SkenHub/-2022-/MDD/回路/部品発注_中尾拓真.xlsx

NAME | 個数 | 単価 | 小計 | 型番 | 注文コード | 手配先 | 販売元 | URL | 備考
20pF ±5% 50V セラミックコンデンサ C0G、NP0 0603（1608メートル法） | 20 | 5.3 | 106 | CC0603JRNPO9BN200 |  | digikey |  | https://www.digikey.jp/product-detail/ja/yageo/CC0603JRNPO9BN200/311-1424-1-ND/2833730
4.7µF ±10% 16V セラミックコンデンサ X5R 0805（2012メートル法） | 10 | 5.3 | 53 | CL21A475KOFNNNG |  | digikey |  | https://www.digikey.jp/product-detail/ja/samsung-electro-mechanics/CL21A475KOFNNNG/1276-6463-1-ND/5958091
0.1µF ±10% 50V セラミックコンデンサ X7R 0603（1608メートル法） | 100 | 6.85 | 685 | CL10B104KB8NNNC |  | digikey |  | https://www.digikey.jp/product-detail/ja/samsung-electro-mechanics/CL10B104KB8NNNC/1276-1000-1-ND/3889086
2.2µF ±20% 50V セラミックコンデンサ X5R 0805（2012メートル法） | 10 | 22.6 | 226 | UMK212ABJ225MG-T |  | digikey |  | https://www.digikey.jp/product-detail/ja/taiyo-yuden/UMK212ABJ225MG-T/587-4962-1-ND/6563805
4.7µF ±10% 50V セラミックコンデンサ X5R 0805（2012メートル法） | 10 | 29.7 | 297 | GRM21BR61H475KE51L |  | digikey |  | https://www.digikey.jp/product-detail/ja/murata-electronics/GRM21BR61H475KE51L/490-10751-1-ND/5251349
3 ポジション ヘッダ コネクタ 0.098インチ（2.50mm） 面実装、ライトアングル 錫 | 25 | 82.2 | 2055 | S3B-XH-SM4-TB(LF)(SN) | 455-2263-1-ND | digikey | JST Sales America Inc. | https://www.digikey.jp/product-detail/ja/jst-sales-america-inc/S3B-XH-SM4-TB-LF-SN/455-2263-1-ND/1651061
4 ポジション ヘッダ コネクタ 0.098インチ（2.50mm） 面実装、ライトアングル 錫 | 40 | 79.1 | 3164 | S4B-XH-SM4-TB(LF)(SN) | 455-2262-1-ND | digikey | JST Sales America Inc. | https://www.digikey.jp/product-detail/ja/jst-sales-america-inc/S4B-XH-SM4-TB-LF-SN/455-2262-1-ND/1651060
ダイオード ショットキー 10V 3A（DC） 面実装 SOD-323 | 6 | 44 | 264 | BAT60JFILM | 497-3707-1-ND | digikey | STMicroelectronics | https://www.digikey.jp/product-detail/ja/stmicroelectronics/BAT60JFILM/497-3707-1-ND/686425
表面実装 青色ＬＥＤ ［３２１６］ ＯＳＢ５１２０６４１Ｅ （１０個入） | 2 | 120 | 240 | OSB5120641E | I-09635 | 秋月電子 | OptoSupply | http://akizukidenshi.com/catalog/g/gI-09635/
8MHz ±20ppm 水晶 18pF 200 Ohms 4-SMD、リードなし | 6 | 126 | 756 | ABM3B-8.000MHZ-B2-T | 535-9720-1-ND | digikey | Abracon LLC | https://www.digikey.jp/product-detail/ja/abracon-llc/ABM3B-8.000MHZ-B2-T/535-9720-1-ND/1873254
10 kOhms ±1% 0.01W チップ抵抗 0603（1608メートル法） アンチサルファー 厚膜 | 10 | 6.6 | 66 | CR0603-FX-1002EAS |  | digikey | Bourns Inc. | https://www.digikey.jp/product-detail/ja/bourns-inc/CR0603-FX-1002EAS/CR0603-FX-1002EASCT-ND/6830120
4.7 kOhms ±5% 0.1W、1/10W チップ抵抗 0603（1608メートル法） 耐湿性 厚膜 | 10 | 1.7 | 17 | CR0603-JW-472ELF | CR0603-JW-472ELFCT-ND | digikey | Bourns Inc. | https://www.digikey.jp/product-detail/ja/bourns-inc/CR0603-JW-472ELF/CR0603-JW-472ELFCT-ND/3592926
1 kOhms ±5% 0.1W、1/10W チップ抵抗 0603（1608メートル法） 耐湿性 厚膜 | 10 | 1.7 | 17 | CR0603-JW-102ELF |  | digikey | Bourns Inc. | https://www.digikey.jp/product-detail/ja/bourns-inc/CR0603-JW-102ELF/CR0603-JW-102ELFCT-ND/3740984
120 Ohms ±5% 0.1W、1/10W チップ抵抗 0603（1608メートル法） 耐湿性 厚膜 | 20 | 1.9 | 38 | CR0603-JW-121ELF |  | digikey | Bourns Inc. | https://www.digikey.jp/product-detail/ja/bourns-inc/CR0603-JW-121ELF/CR0603-JW-121ELFCT-ND/3925335
表面実装用タクトスイッチ（５個入） | 2 | 100 | 200 | SKRPACE010 | P-06185 | 秋月電子 | アルプス電気株式会社(ALPS) | http://akizukidenshi.com/catalog/g/gP-06185/
表面実装ＤＩＰスイッチ ４Ｐ | 6 | 100 | 600 | KHS42E | P-08929 | 秋月電子 | オータックス株式会社(OTAX) | http://akizukidenshi.com/catalog/g/gP-08929/
IC TRANSCEIVER FULL 1/1 8SO | 6 | 169 | 1014 | MAX3058ASA+T | MAX3058ASA+CT-ND | digikey | Maxim Integrated | https://www.digikey.jp/product-detail/ja/maxim-integrated/MAX3058ASA-T/MAX3058ASA-CT-ND/5402248
IC REG LINEAR 3.3V 500MA SOT23-5 | 6 | 58 | 348 | SPX3819M5-L-3-3/TR | 1016-1873-1-ND | digikey | MaxLinear, Inc. | https://www.digikey.jp/product-detail/ja/maxlinear-inc/SPX3819M5-L-3-3-TR/1016-1873-1-ND/3586590
STM32F446RET6 | 2 | 772.2 | 1544.4 | STM32F446RET6 | 497-15376-ND | digikey | STMicroelectronics | https://www.digikey.jp/product-detail/ja/stmicroelectronics/STM32F446RET6/497-15376-ND/5175962
