SkenHub/-2022-/ver1.brd

## EAGLE design ver1.brd (2023-12-15)

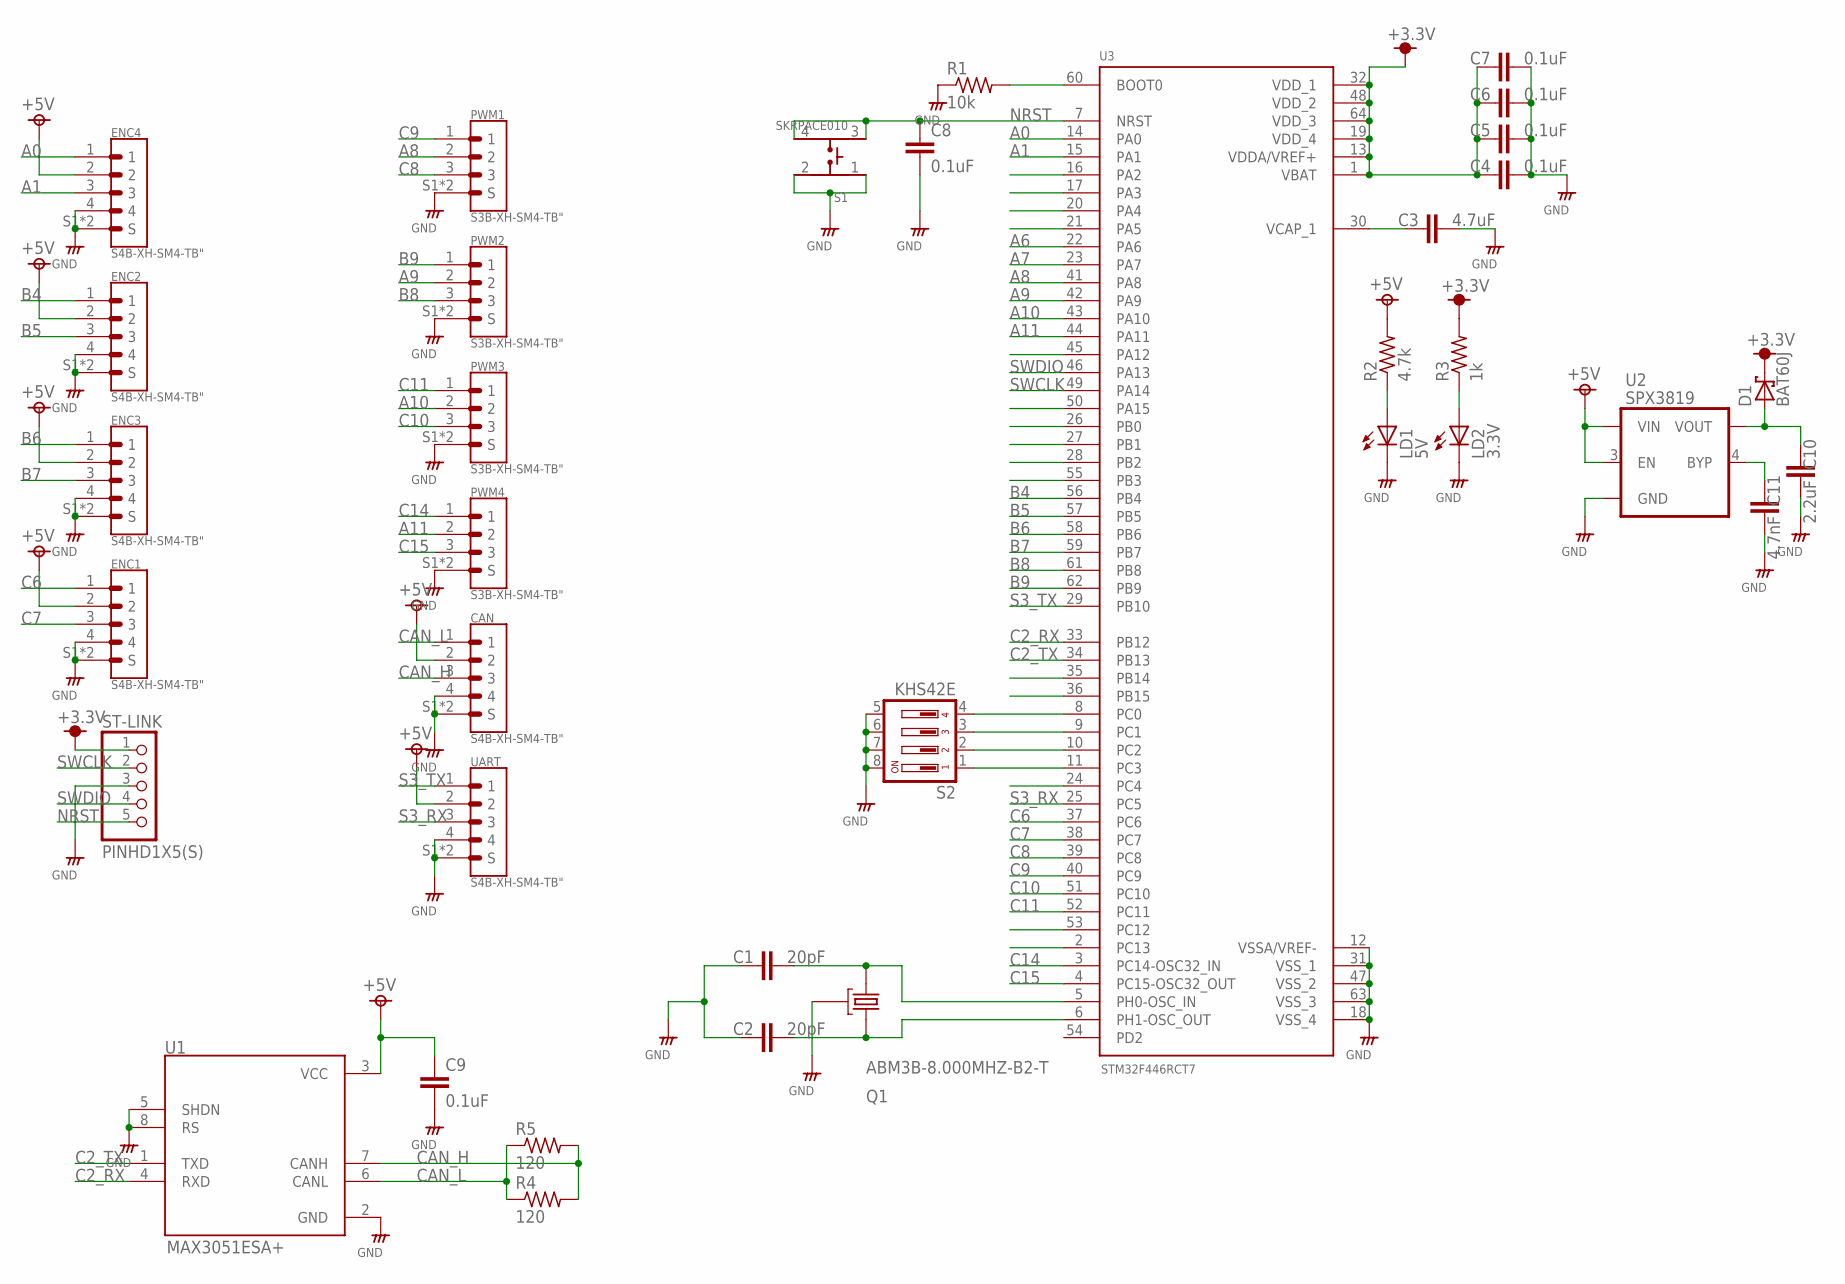
[picture p10: schematic ver1.sch]

Parts:
C1, C2: 20pF; C0603
C3: 4.7uF; C0805
C4, C5, C6, C7: 0.1uF; C0805
C8, C9: 0.1uF; C0603
C10: 2.2uF; C0603
C11: 4.7nF; C0603
CAN: S4B-XH-SM4-TB"; S4B-XH-SM4-TB
D1: BAT60J; SOD323_ST
ENC1, ENC2, ENC3, ENC4: S4B-XH-SM4-TB"; S4B-XH-SM4-TB
LD1: 5V; CHIP-LED3216
LD2: 3.3V; CHIP-LED3216
PWM1, PWM2, PWM3, PWM4: S3B-XH-SM4-TB"; S3B-XH-SM4-TB
Q1: ABM3B-8.000MHZ-B2-T; OSCCC500X320X110-4N
R1: 10k; R0603
R2: 4.7k; R0603
R3: 1k; R0603
R4, R5: 120; R0603
S1: SKRPACE010; SW_SKRPACE010
S2: KHS42E
ST-LINK: PINHD1X5(S); 1X5(XH_S)
U1: MAX3051ESA+; SOIC127P600X175-8N
U2: SPX3819; SOT23-5
U3: STM32F446RCT7; QFP50P1200X1200X160-64N
UART: S4B-XH-SM4-TB"; S4B-XH-SM4-TB

Connections:
+3V3: C4.1, C5.1, C6.1, C7.1, D1.C, R3.2, ST-LINK.1, U3.1 (VBAT), U3.13 (VDDA/VREF+), U3.19 (VDD_4), U3.32 (VDD_1), U3.48 (VDD_2), U3.64 (VDD_3)
+5V: C9.1, CAN.2, ENC1.2, ENC2.2, ENC3.2, ENC4.2, R2.2, U1.3 (VCC), U2.1 (VIN), U2.3 (EN), UART.2
A0: ENC4.1, U3.14 (PA0)
A1: ENC4.3, U3.15 (PA1)
A6: U3.22 (PA6)
A7: U3.23 (PA7)
A8: PWM1.2, U3.41 (PA8)
A9: PWM2.2, U3.42 (PA9)
A10: PWM3.2, U3.43 (PA10)
A11: PWM4.2, U3.44 (PA11)
B4: ENC2.1, U3.56 (PB4)
B5: ENC2.3, U3.57 (PB5)
B6: ENC3.1, U3.58 (PB6)
B7: ENC3.3, U3.59 (PB7)
B8: PWM2.3, U3.61 (PB8)
B9: PWM2.1, U3.62 (PB9)
C2_RX: U1.4 (RXD), U3.33 (PB12)
C2_TX: U1.1 (TXD), U3.34 (PB13)
C6: ENC1.1, U3.37 (PC6)
C7: ENC1.3, U3.38 (PC7)
C8: PWM1.3, U3.39 (PC8)
C9: PWM1.1, U3.40 (PC9)
C10: PWM3.3, U3.51 (PC10)
C11: PWM3.1, U3.52 (PC11)
C14: PWM4.1, U3.3 (PC14-OSC32_IN)
C15: PWM4.3, U3.4 (PC15-OSC32_OUT)
CAN_H: CAN.3, R4.2, R5.2, U1.7 (CANH)
CAN_L: CAN.1, R4.1, R5.1, U1.6 (CANL)
GND: C1.1, C2.1, C3.2, C4.2, C5.2, C6.2, C7.2, C8.2, C9.2, C10.2, C11.2, CAN.4, CAN.S1 (S), CAN.S2 (S), ENC1.4, ENC1.S1 (S), ENC1.S2 (S), ENC2.4, ENC2.S1 (S), ENC2.S2 (S), ENC3.4, ENC3.S1 (S), ENC3.S2 (S), ENC4.4, ENC4.S1 (S), ENC4.S2 (S), LD1.C, LD2.C, PWM1.S1 (S), PWM1.S2 (S), PWM2.S1 (S), PWM2.S2 (S), PWM3.S1 (S), PWM3.S2 (S), PWM4.S1 (S), PWM4.S2 (S), Q1.2 (GND), Q1.4 (GND), R1.1, S1.1, S1.2, S2.5, S2.6, S2.7, S2.8, ST-LINK.3, U1.2 (GND), U1.5 (SHDN), U1.8 (RS), U2.2 (GND), U3.12 (VSSA/VREF-), U3.18 (VSS_4), U3.31 (VSS_1), U3.47 (VSS_2), U3.63 (VSS_3), UART.4, UART.S1 (S), UART.S2 (S)
unnamed: C1.2, Q1.1, U3.5 (PH0-OSC_IN)
unnamed: C2.2, Q1.3, U3.6 (PH1-OSC_OUT)
unnamed: R1.2, U3.60 (BOOT0)
unnamed: C3.1, U3.30 (VCAP_1)
unnamed: LD1.A, R2.1
unnamed: LD2.A, R3.1
unnamed: C11.1, U2.4 (BYP)
unnamed: C10.1, D1.A, U2.5 (VOUT)
unnamed: S2.4, U3.8 (PC0)
unnamed: S2.3, U3.9 (PC1)
unnamed: S2.2, U3.10 (PC2)
unnamed: S2.1, U3.11 (PC3)
NRST: C8.1, S1.3, S1.4, ST-LINK.5, U3.7 (NRST)
S3_RX: U3.25 (PC5), UART.3
S3_TX: U3.29 (PB10), UART.1
SWCLK: ST-LINK.2, U3.49 (PA14)
SWDIO: ST-LINK.4, U3.46 (PA13)

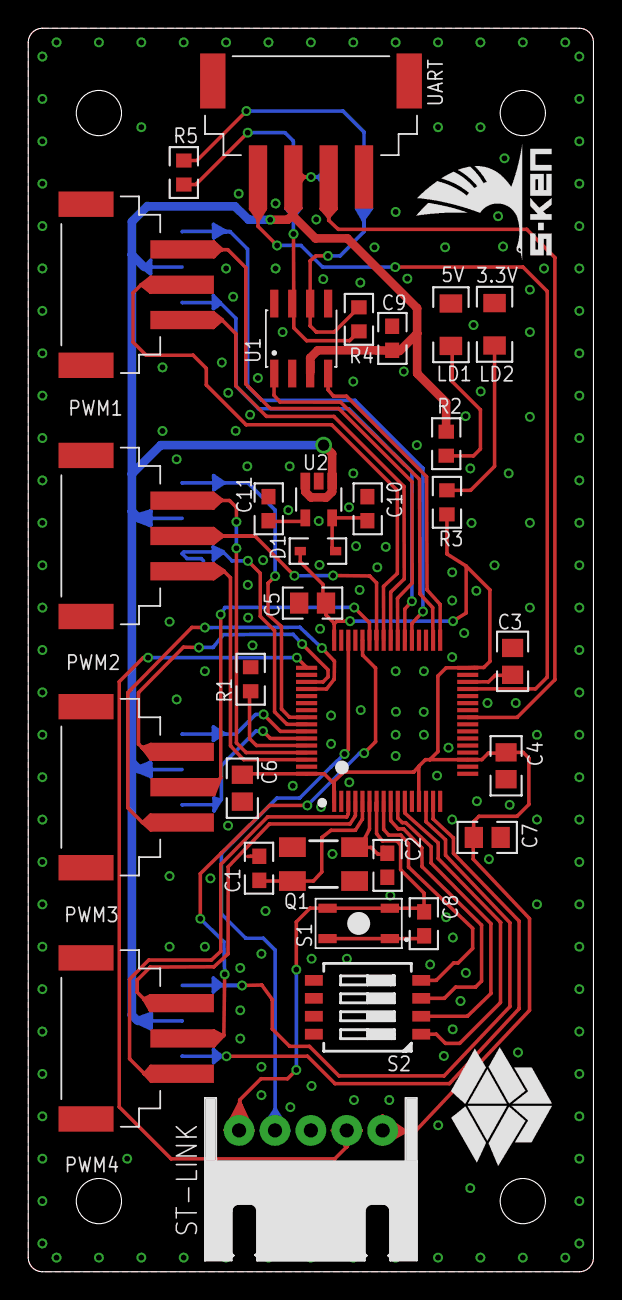
[picture p11: board ver1.brd from above]

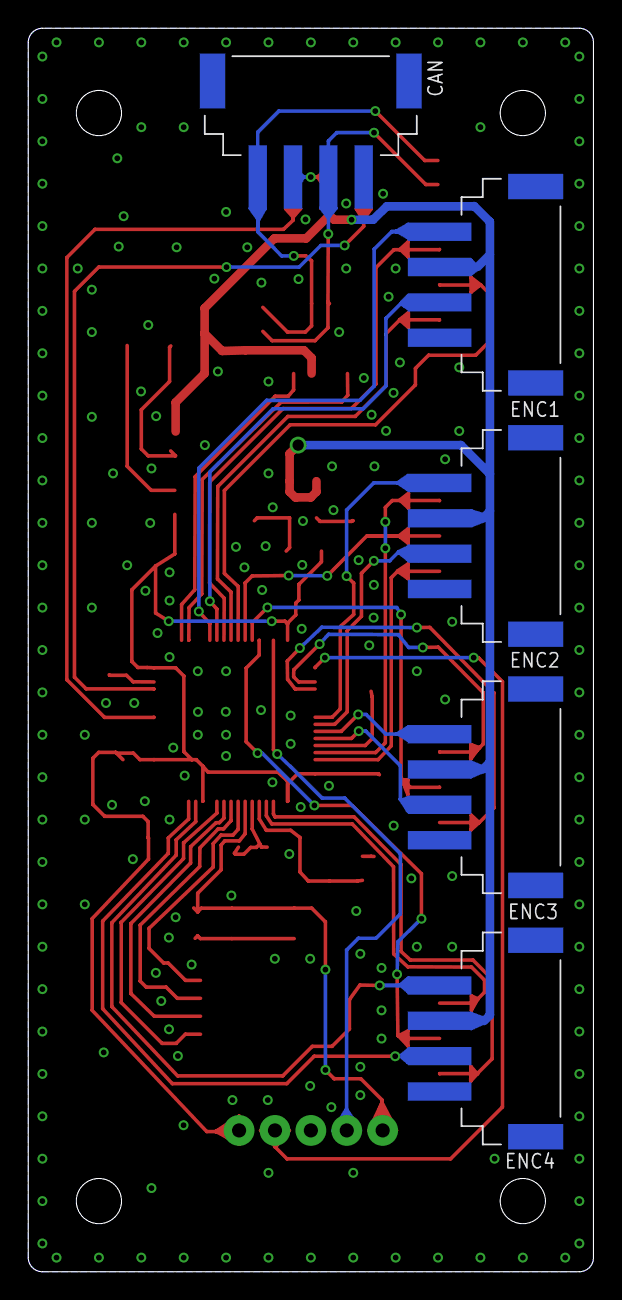
[picture p12: board ver1.brd from below]

Board: 2 copper layers, 40.0 x 88.0 mm, 38 parts (5 on the bottom side), 44 nets.

Other parts of the board:
U$3: SKEN_LOGO
U$4: BLACK_BOX
